gswdh/PSU-Hardware/sim.asc

C1: cap; 22p
C2: cap; 220p
C3: cap; 10µ
C4: cap; 10p
C6: cap; 100n
L1: ind; 1µ
L2: ind; 1µ
M1: nmos; BSG0811NDQ2
M2: nmos; BSG0811NDQ2
R1: res; 10
R2: res; 1
R3: res; 3k
R4: res; 1k
R5: res; 10
R6: res; 3k
R7: res; 1k
R8: res; 1Meg
R9: res; 10
R11: res; 10k
R12: res; 10k
R13: res; 10k
R14: res; 10k
U1: LT1630
U2: LT1630
U3: LT1630
V1: voltage; 15
V2: voltage; 5
V3: voltage; 11
V5: voltage; 1
Named nets: +15V, -5V, 0, VOUT+, VOUT-, +15v, isense, vsense
.tran 1u 1m
