gswdh/PSU-Hardware/power.brd

## EAGLE design power.brd (2020-10-30)

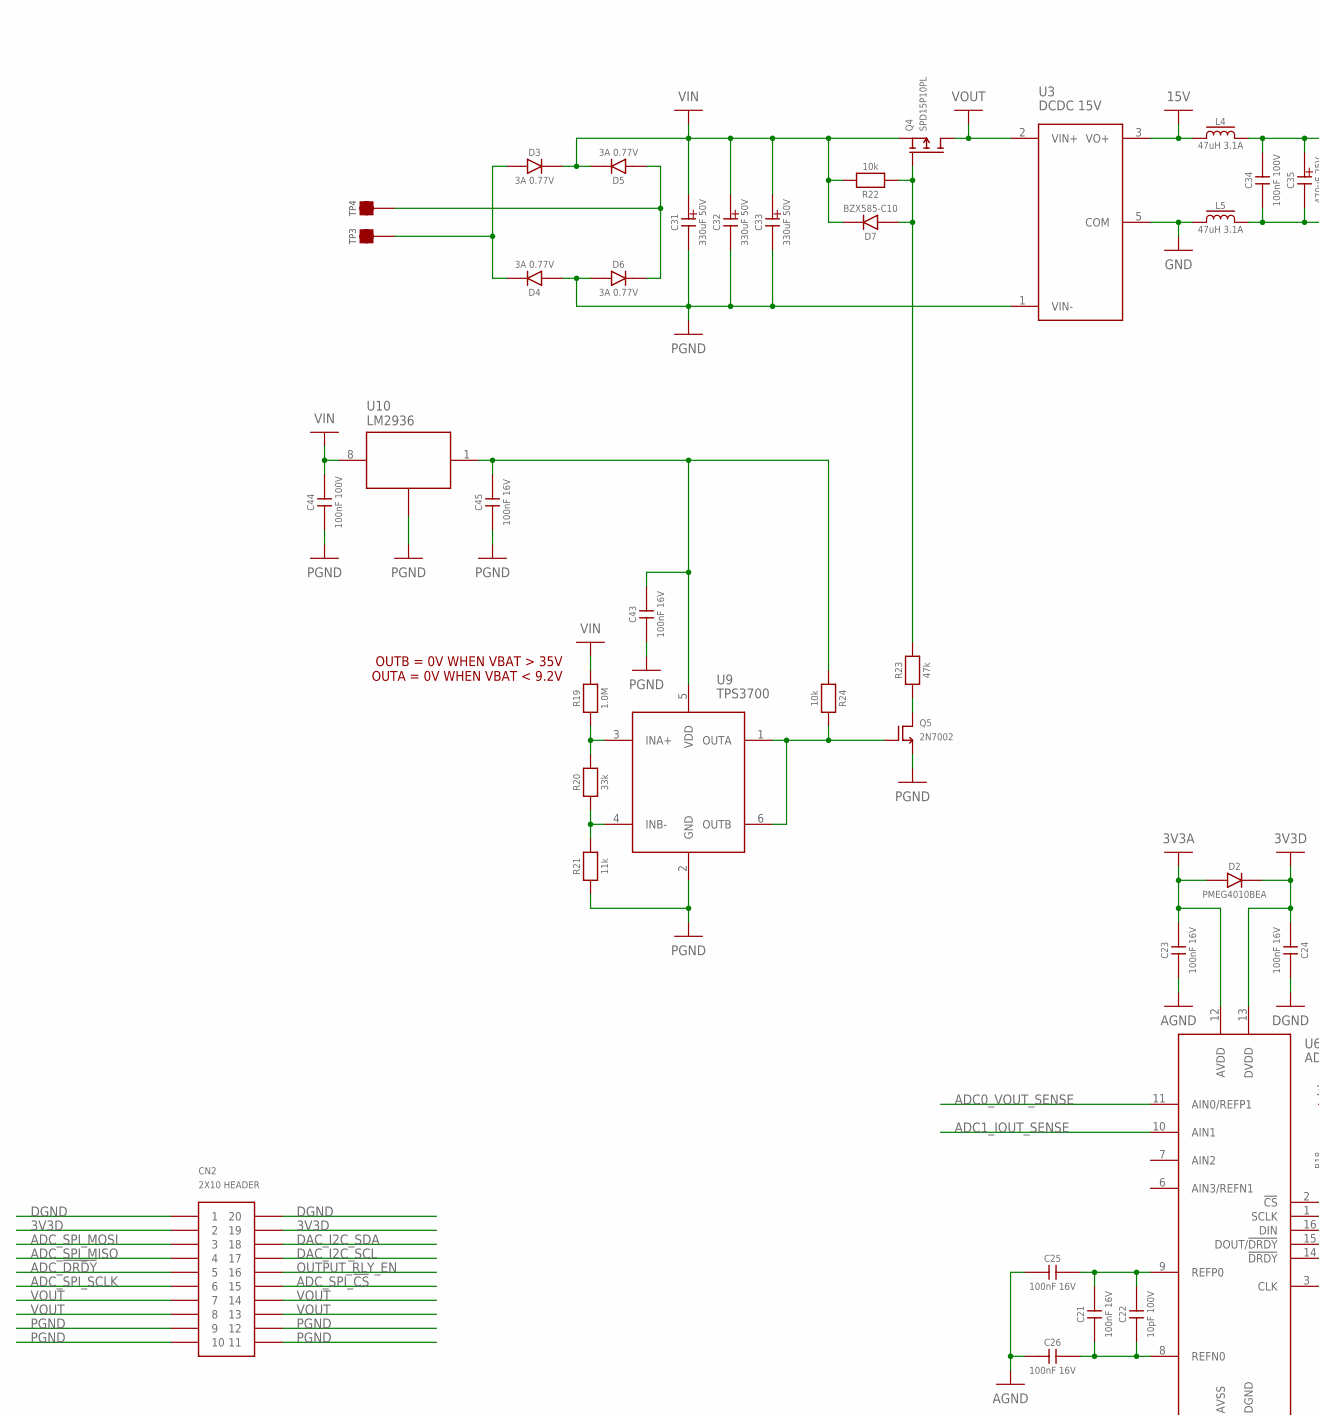
[picture p1: schematic power.sch, part in row 1, column 1]

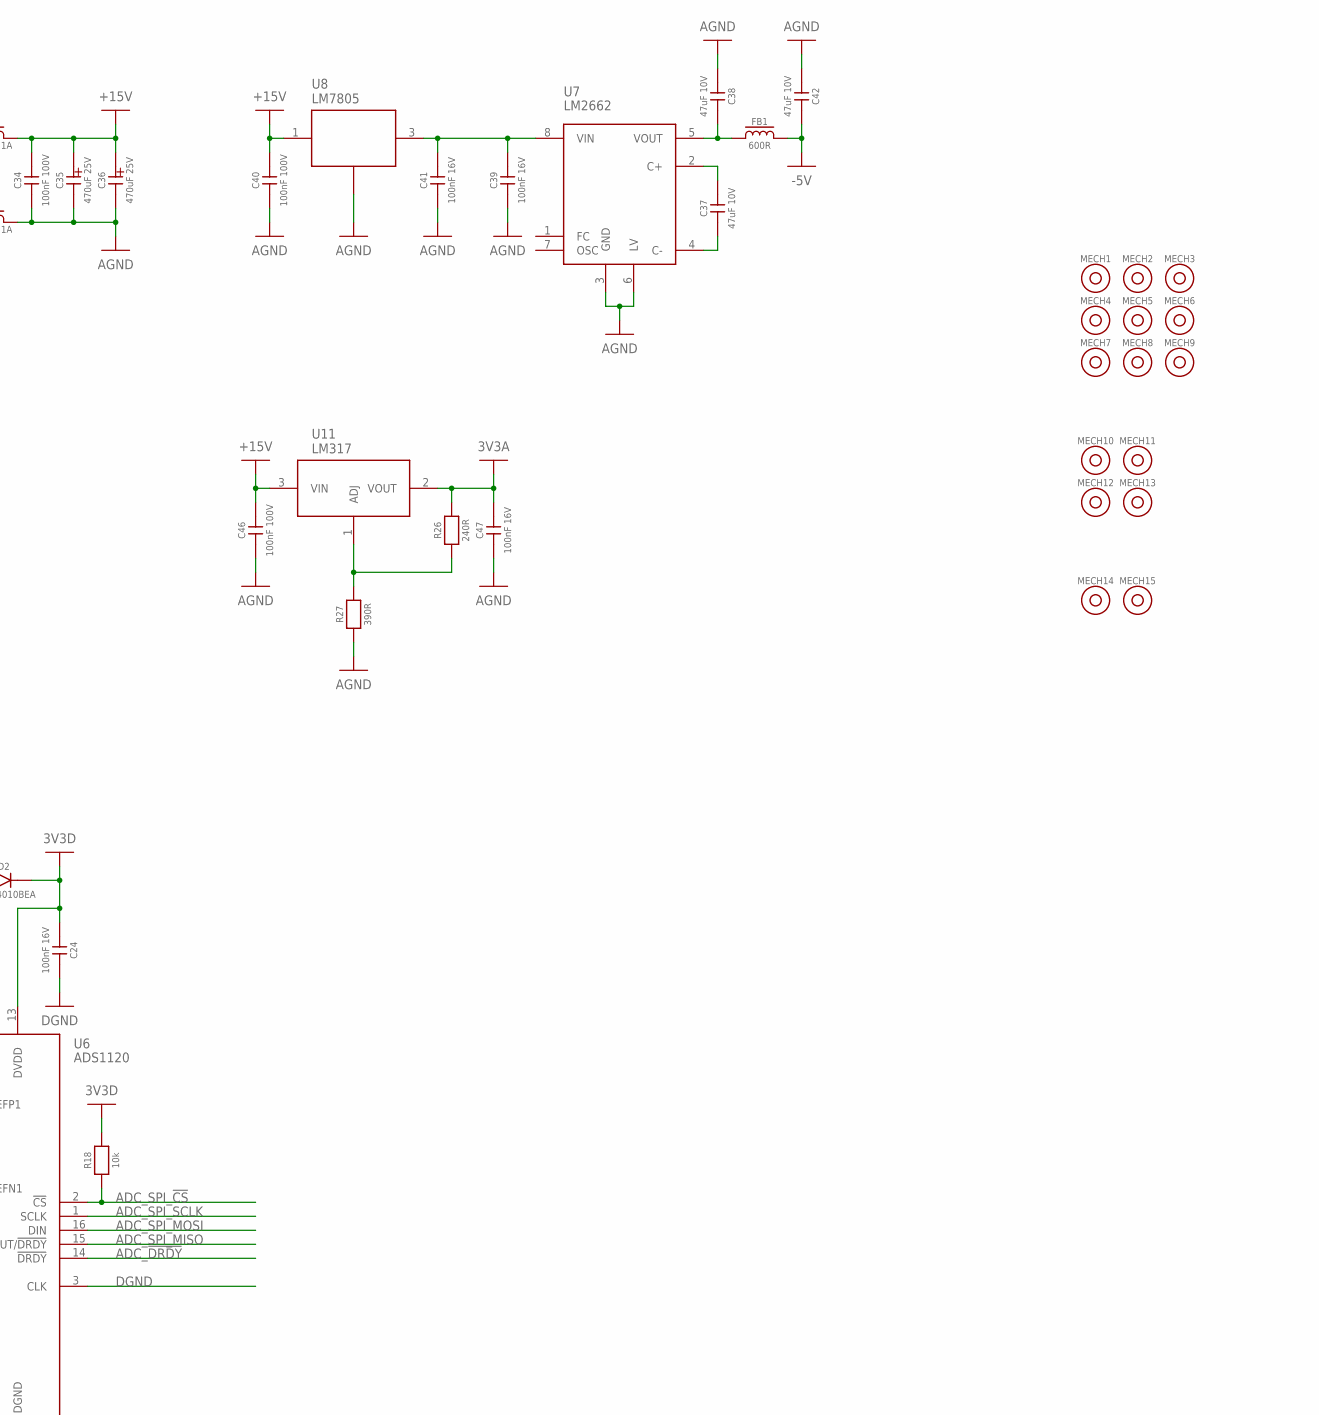
[picture p2: schematic power.sch, part in row 1, column 2]

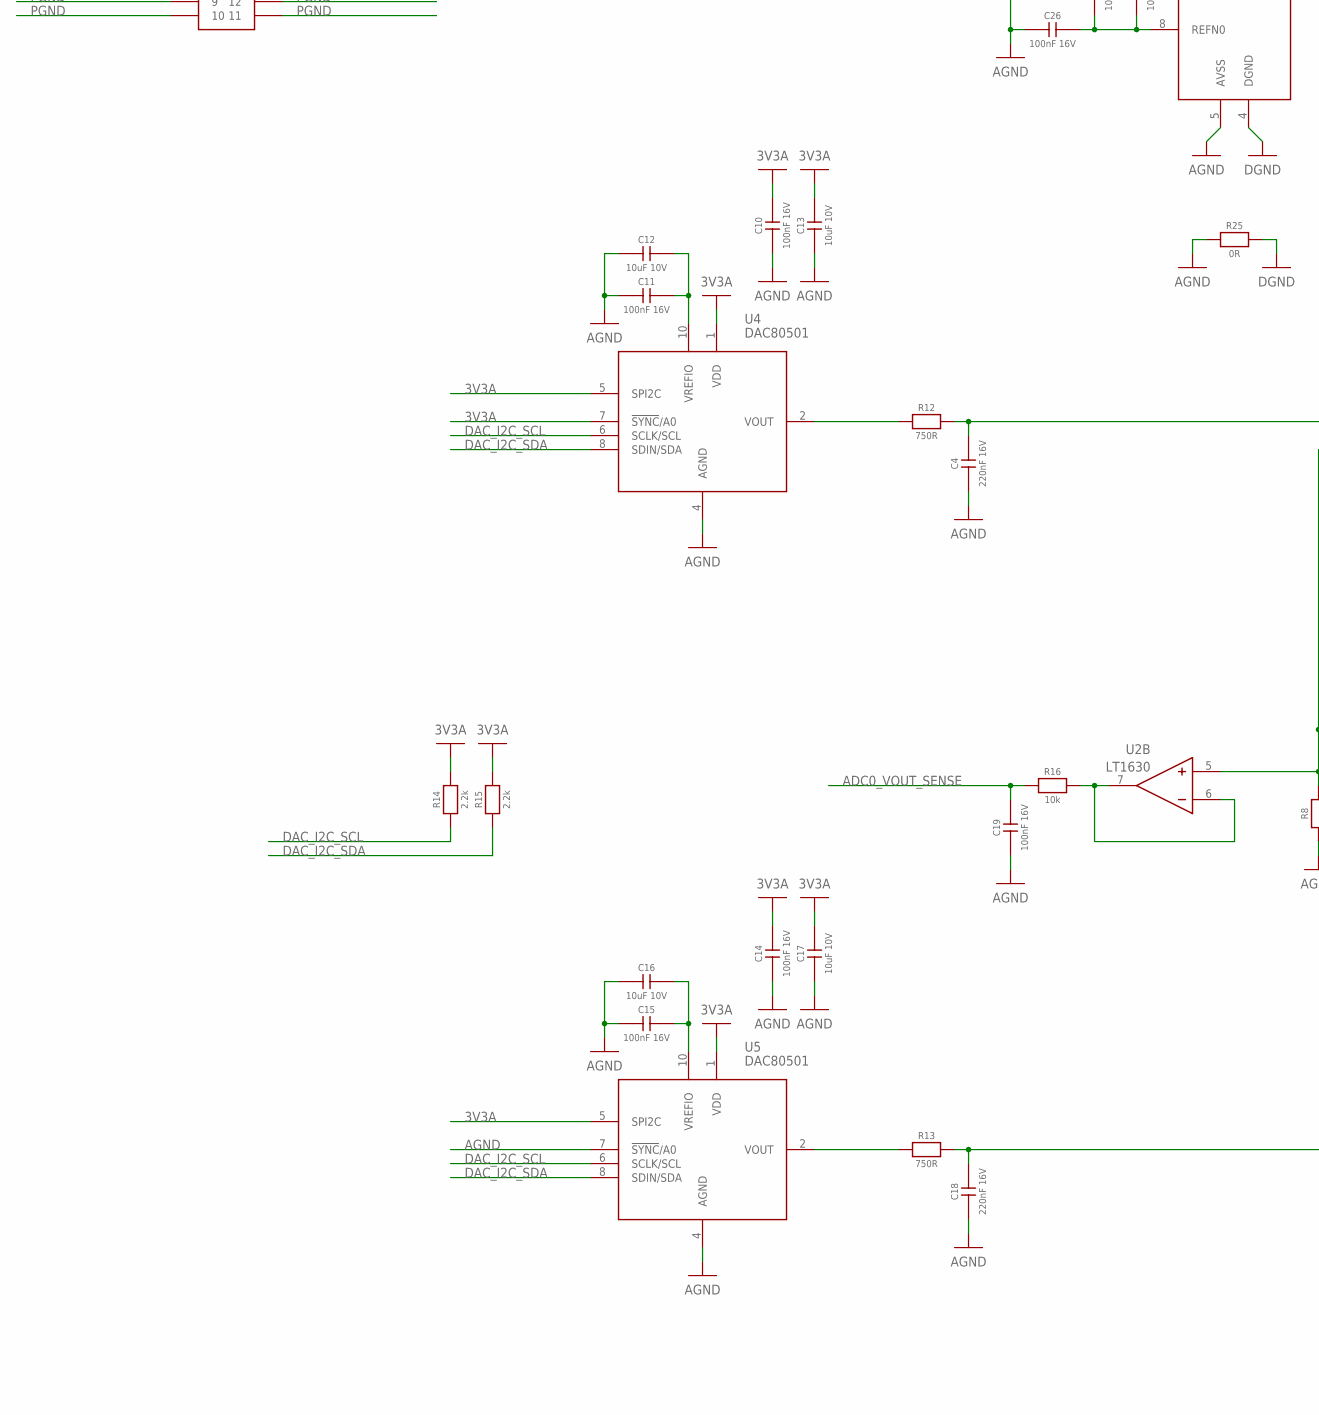
[picture p3: schematic power.sch, part in row 2, column 1]

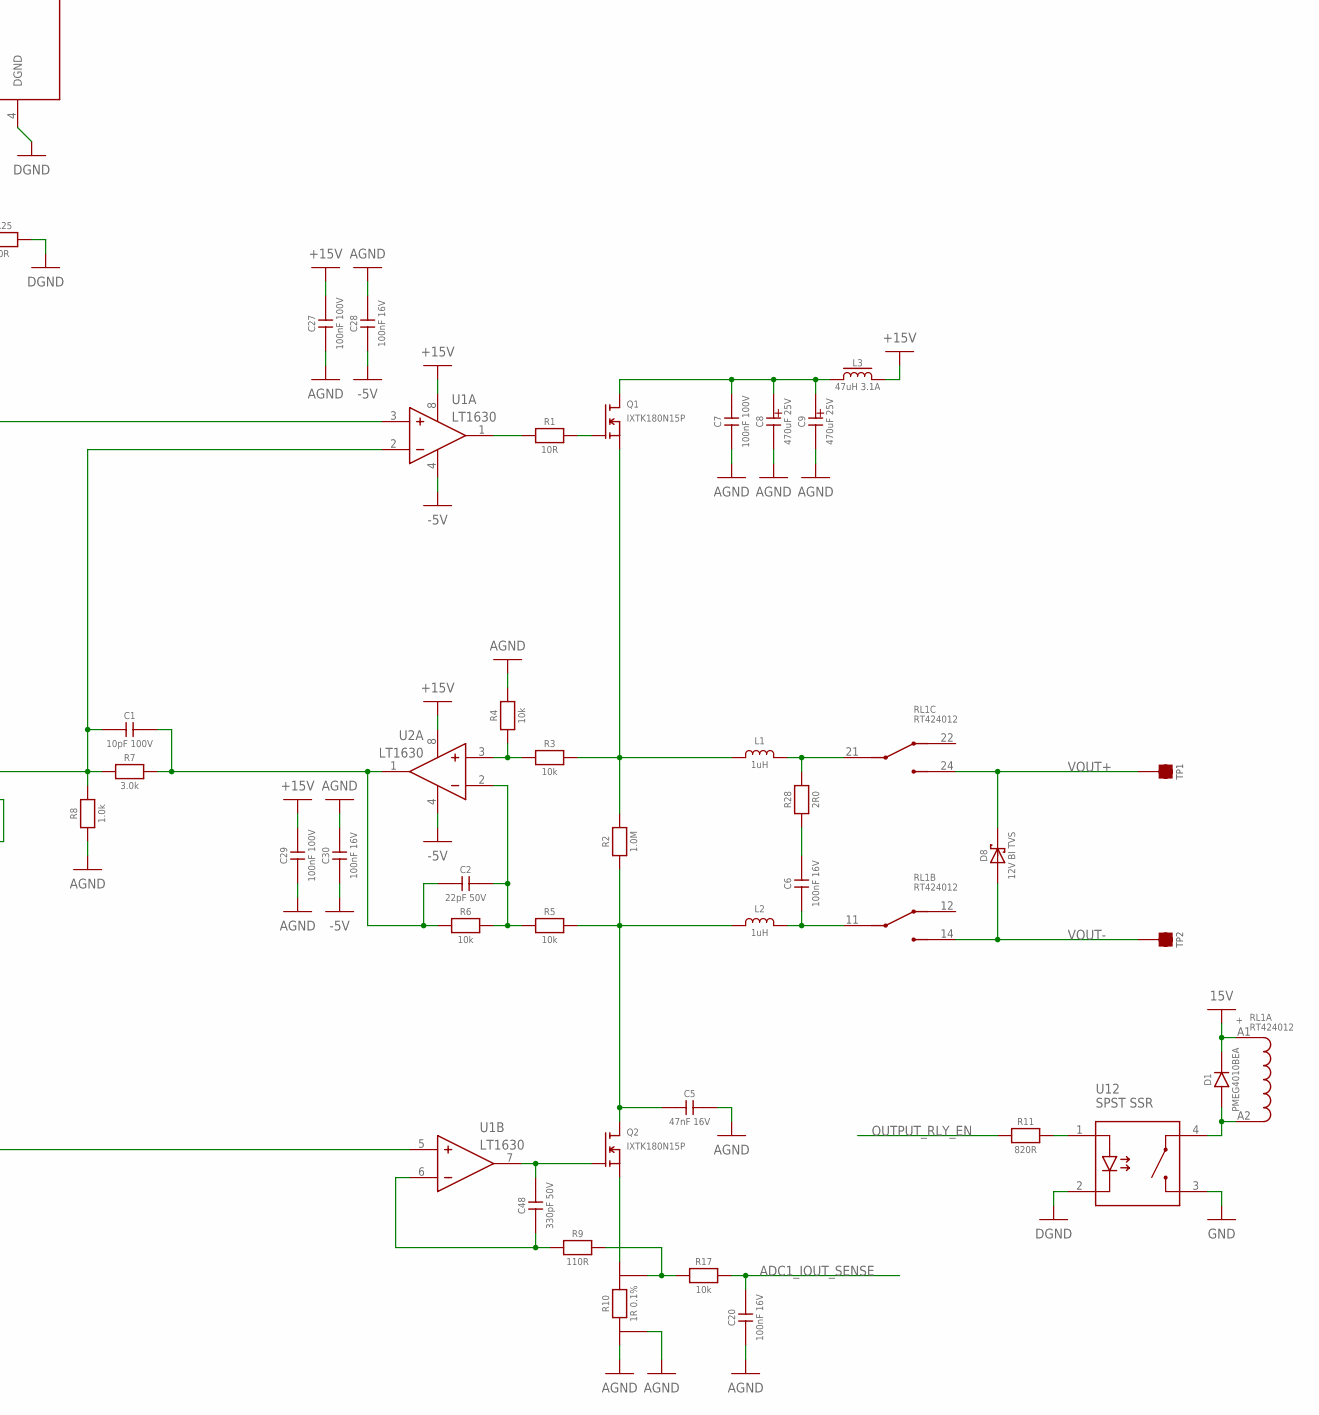
[picture p4: schematic power.sch, part in row 2, column 2]

Parts:
C1, C22: 10pF 100V; 0603
C2: 22pF 50V; 0603
C4, C18: 220nF 16V; 0603
C5: 47nF 16V; 0603
C6, C10, C11, C14, C15, C19, C20, C21, C23, C24, C25, C26, C28, C30, C39, C41, C43, C45, C47: 100nF 16V; 0603
C7, C27, C29, C34, C40, C44, C46: 100nF 100V; 0603
C8, C9, C35, C36: 470uF 25V; 10MM_RADIAL_5MM_PITCH
C12, C13, C16, C17: 10uF 10V; 0603
C31, C32, C33: 330uF 50V; 10MM_RADIAL_5MM_PITCH
C37, C38, C42: 47uF 10V; 1206
C48: 330pF 50V; 0603
CN2: 2X10 HEADER; 2X10PIN_HEADER
D1, D2: PMEG4010BEA; SOD-323
D3, D4, D5, D6: 3A 0.77V; SOD128
D7: BZX585-C10; SOD_523
D8: 12V BI TVS; DO214AC
FB1: 600R; 0603
L1, L2: 1uH; DIY_10X13MM_INDUCTOR
L3, L4, L5: 47uH 3.1A; SRR1210
MECH1, MECH2, MECH3, MECH4, MECH5, MECH6, MECH7, MECH8, MECH9, MECH10, MECH11, MECH12, MECH13, MECH14, MECH15: 6mm x 3mm; MOUNTHOLE_6X3
Q1, Q2: IXTK180N15P; TO264F
Q4: SPD15P10PL; TO252
Q5: 2N7002; SOT23-3
R1: 10R; 0603
R2, R19: 1.0M; 0603
R3, R4, R5, R6, R16, R17, R18, R22, R24: 10k; 0603
R7: 3.0k; 0603
R8: 1.0k; 0603
R9: 110R; 0603
R10: 1R 0.1%; 2512_4WIRE
R11: 820R; 0603
R12, R13: 750R; 0603
R14, R15: 2.2k; 0603
R20: 33k; 0603
R21: 11k; 0603
R23: 47k; 0603
R25: 0R; 0603
R26: 240R; 0603
R27: 390R; 0603
R28: 2R0; 1206
RL1: RT424012; 30MMDPDTRELAY
TP1, TP2, TP3, TP4: TEST_POINT_SQUARE; OSPREY_HSS_PAD
U1, U2: LT1630; SO8
U3: DCDC 15V; PDQE10
U4, U5: DAC80501; VSSOP10
U6: ADS1120; TSSOP16
U7: LM2662; SO8
U8: LM7805; TO220
U9: TPS3700; SOT23-6
U10: LM2936; SO8
U11: LM317; TO220
U12: SPST SSR; CPC1002N

Connections:
3V3A: C10.2, C13.2, C14.2, C17.2, C23.2, C47.2, D2.A, R14.2, R15.2, R26.2, U4.1 (VDD), U4.5 (SPI2C), U4.7 (!SYNC!/A0), U5.1 (VDD), U5.5 (SPI2C), U6.12 (AVDD), U11.2 (VOUT)
3V3D: C24.1, CN2.2, CN2.19, D2.K, R18.2, U6.13 (DVDD)
15V: D1.K, L4.1, RL1.A1, U3.3 (VO+)
+15V: C27.2, C29.2, C34.2, C35.2 (A), C36.2 (A), C40.2, C46.2, L3.2, L4.2, U1.8 (V+), U2.8 (V+), U8.1 (VIN), U11.3 (VIN)
-5V: C28.1, C30.1, C42.2, FB1.2, U1.4 (V-), U2.4 (V-)
ADC0_VOUT_SENSE: C19.2, R16.1, U6.11 (AIN0/REFP1)
ADC1_IOUT_SENSE: C20.2, R17.2, U6.10 (AIN1)
ADC_!DRDY: CN2.5, U6.14 (!DRDY)
ADC_SPI_!CS: CN2.15, R18.1, U6.2 (!CS)
ADC_SPI_MISO: CN2.4, U6.15 (DOUT/!DRDY)
ADC_SPI_MOSI: CN2.3, U6.16 (DIN)
ADC_SPI_SCLK: CN2.6, U6.1 (SCLK)
AGND: C4.1, C5.2, C7.1, C8.1 (K), C9.1 (K), C10.1, C11.1, C12.1, C13.1, C14.1, C15.1, C16.1, C17.1, C18.1, C19.1, C20.1, C23.1, C25.1, C26.1, C27.1, C28.2, C29.1, C30.2, C34.1, C35.1 (K), C36.1 (K), C38.1, C39.1, C40.1, C41.1, C42.1, C46.1, C47.1, L5.2, R4.2, R8.1, R10.1 (E1), R10.2 (I1), R25.1, R27.1, U4.4 (AGND), U5.4 (AGND), U5.7 (!SYNC!/A0), U6.5 (AVSS), U7.3 (GND), U7.6 (LV), U8.2 (GND)
DAC_I2C_SCL: CN2.17, R14.1, U4.6 (SCLK/SCL), U5.6 (SCLK/SCL)
DAC_I2C_SDA: CN2.18, R15.1, U4.8 (SDIN/SDA), U5.8 (SDIN/SDA)
DGND: C24.2, CN2.1, CN2.20, R25.2, U6.3 (CLK), U6.4 (DGND), U12.2 (LED_K)
GND: L5.1, U3.5 (COM), U12.3 (SW2)
unnamed: R1.1, U1.1 (OUT)
unnamed: Q1.1 (G), R1.2
unnamed: L1.1, Q1.3 (S), R2.2, R3.2
unnamed: C5.1, L2.1, Q2.2 (D), R2.1, R5.2
unnamed: R3.1, R4.1, U2.3 (+)
unnamed: C2.2, R5.1, R6.2, U2.2 (-)
unnamed: C1.2, C2.1, R6.1, R7.2, U2.1 (OUT)
unnamed: R16.2, U2.6 (-), U2.7 (OUT)
unnamed: C48.2, Q2.1 (G), U1.7 (OUT)
unnamed: C4.2, R12.2, U1.3 (+)
unnamed: C48.1, R9.1, U1.6 (-)
unnamed: L1.2, R28.2, RL1.21 (1)
unnamed: R11.2, U12.1 (LED_A)
unnamed: C6.1, L2.2, RL1.11 (1)
unnamed: R26.1, R27.2, U11.1 (ADJ)
unnamed: C21.2, C22.2, C25.2, U6.9 (REFP0)
unnamed: C7.2, C8.2 (A), C9.2 (A), L3.1, Q1.2 (D)
unnamed: C18.2, R13.2, U1.5 (+)
unnamed: D1.A, RL1.A2, U12.4 (SW1)
unnamed: C11.2, C12.2, U4.10 (VREFIO)
unnamed: R12.1, U4.2 (VOUT)
unnamed: C15.2, C16.2, U5.10 (VREFIO)
unnamed: R13.1, U5.2 (VOUT)
unnamed: C21.1, C22.1, C26.2, U6.8 (REFN0)
unnamed: C43.2, C45.2, R24.1, U9.5 (VDD), U10.1 (VOUT)
unnamed: D5.A, D6.K, TP4.1
unnamed: D3.A, D4.K, TP3.1
unnamed: C6.2, R28.1
unnamed: Q2.3 (S), R10.4 (I2)
unnamed: C37.2, U7.2 (C+)
unnamed: C37.1, U7.4 (C-)
unnamed: C38.2, FB1.1, U7.5 (VOUT)
unnamed: C39.2, C41.2, U7.8 (VIN), U8.3 (VOUT)
unnamed: R19.1, R20.2, U9.3 (INA+)
unnamed: R20.1, R21.2, U9.4 (INB-)
unnamed: D7.A, Q4.1 (G), R22.1, R23.2
unnamed: Q5.2 (D), R23.1
unnamed: Q5.1 (G), R24.2, U9.1 (OUTA), U9.6 (OUTB)
unnamed: R9.2, R10.3 (E2), R17.1
unnamed: C1.1, R7.1, R8.2, U1.2 (-), U2.5 (+)
OUTPUT_RLY_EN: CN2.16, R11.1
PGND: C31.1 (K), C32.1 (K), C33.1 (K), C43.1, C44.1, C45.1, CN2.9, CN2.10, CN2.11, CN2.12, D4.A, D6.A, Q5.3 (S), R21.1, U3.1 (VIN-), U9.2 (GND), U10.2 (GND), U10.3 (GND), U10.6 (GND), U10.7 (GND)
VIN: C31.2 (A), C32.2 (A), C33.2 (A), C44.2, D3.K, D5.K, D7.K, Q4.3 (S), R19.2, R22.2, U10.8 (VIN)
VOUT: CN2.7, CN2.8, CN2.13, CN2.14, Q4.2 (D), U3.2 (VIN+)
VOUT+: D8.K, RL1.24 (3), TP1.1
VOUT-: D8.A, RL1.14 (3), TP2.1

Notes on the sheet:
OUTB = 0V WHEN VBAT > 35V OUTA = 0V WHEN VBAT < 9.2V

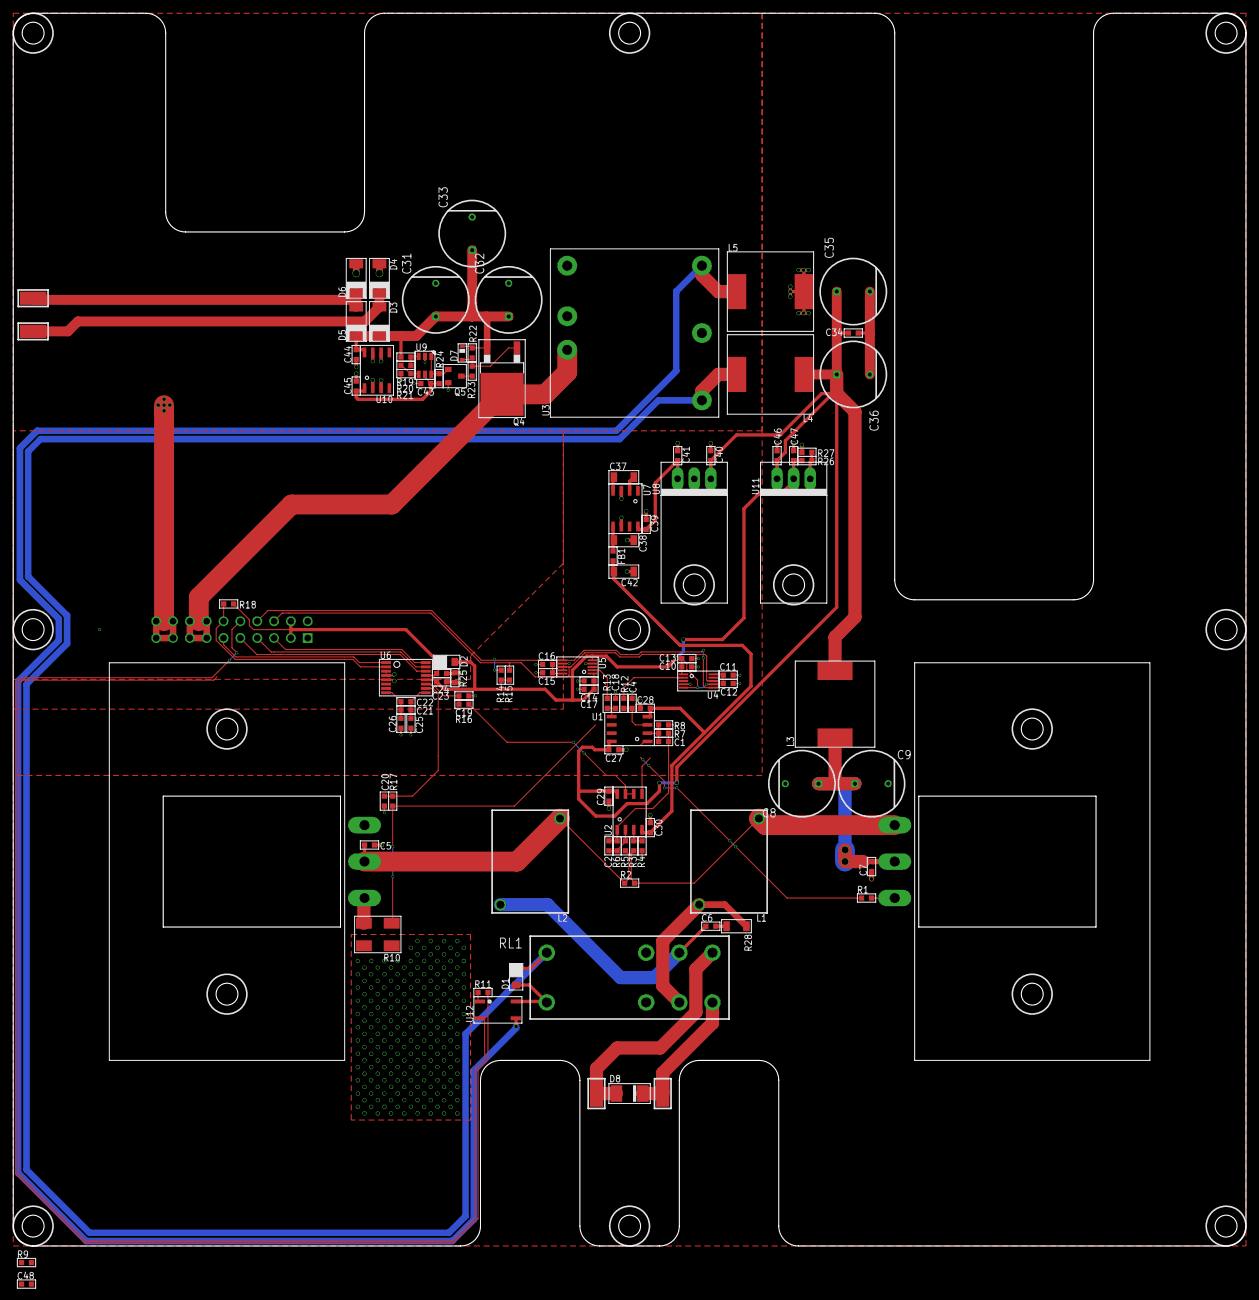
[picture p5: board power.brd from above]

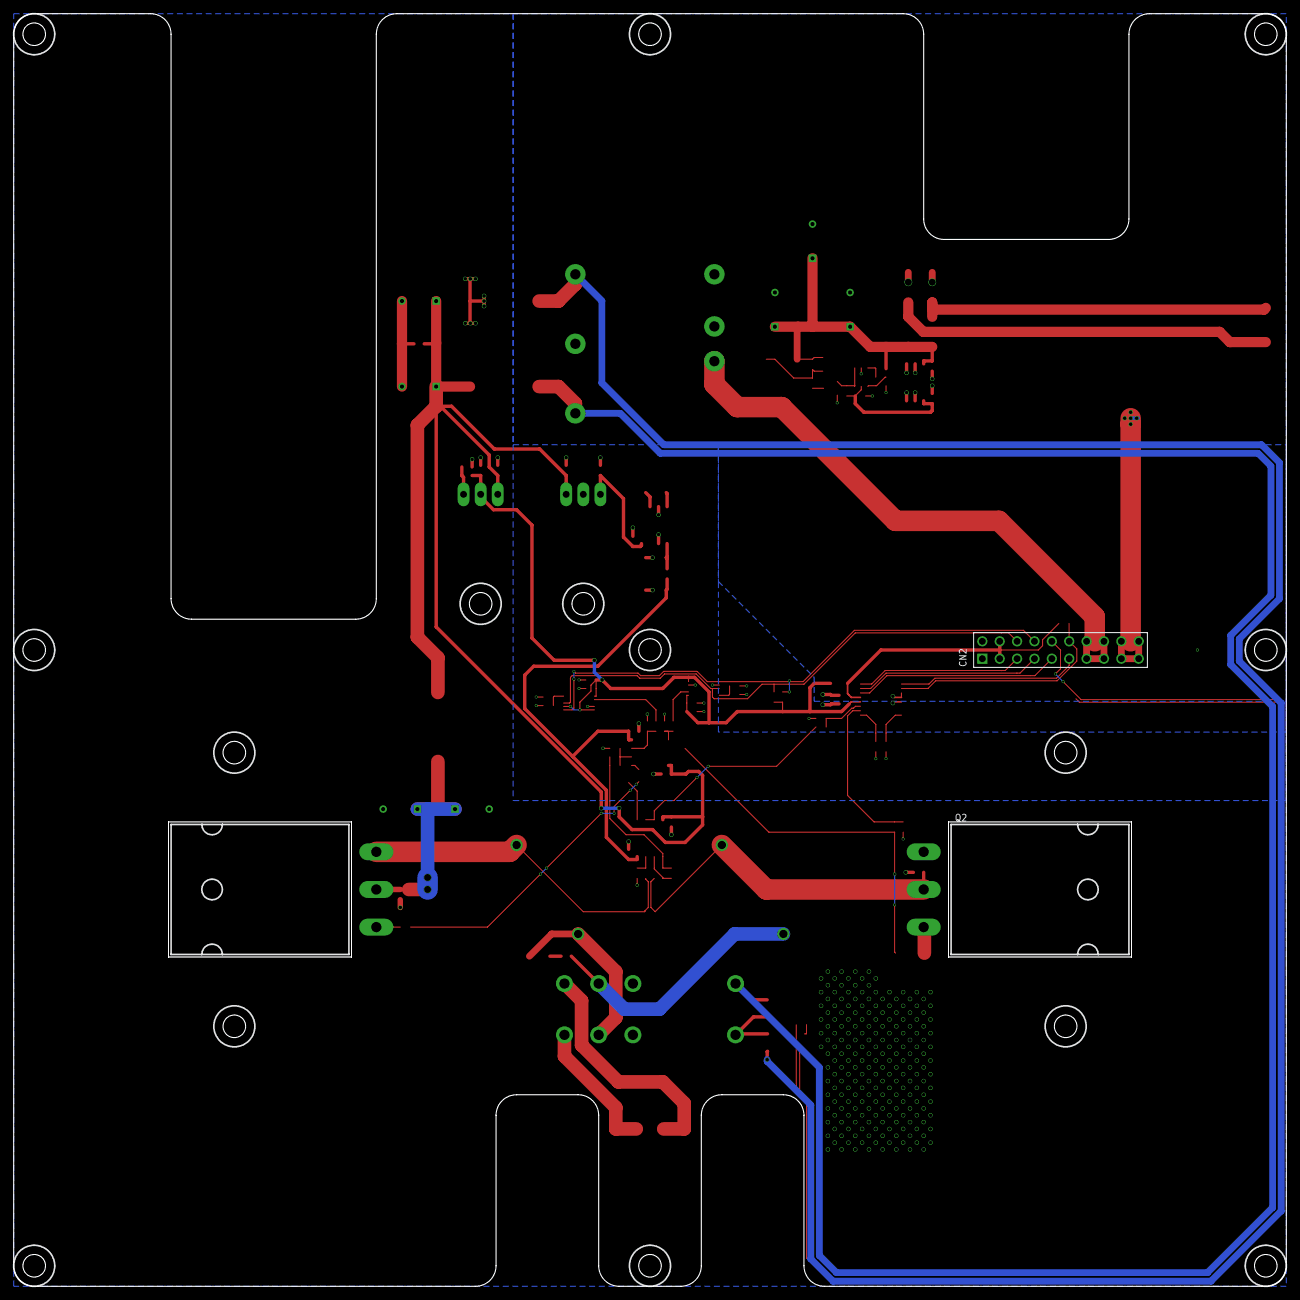
[picture p6: board power.brd from below]

Board: 4 copper layers, 186.0 x 186.0 mm, 126 parts (3 on the bottom side), 63 nets.
