gswdh/PSU-Hardware/control.brd

## EAGLE design control.brd (2020-10-30)

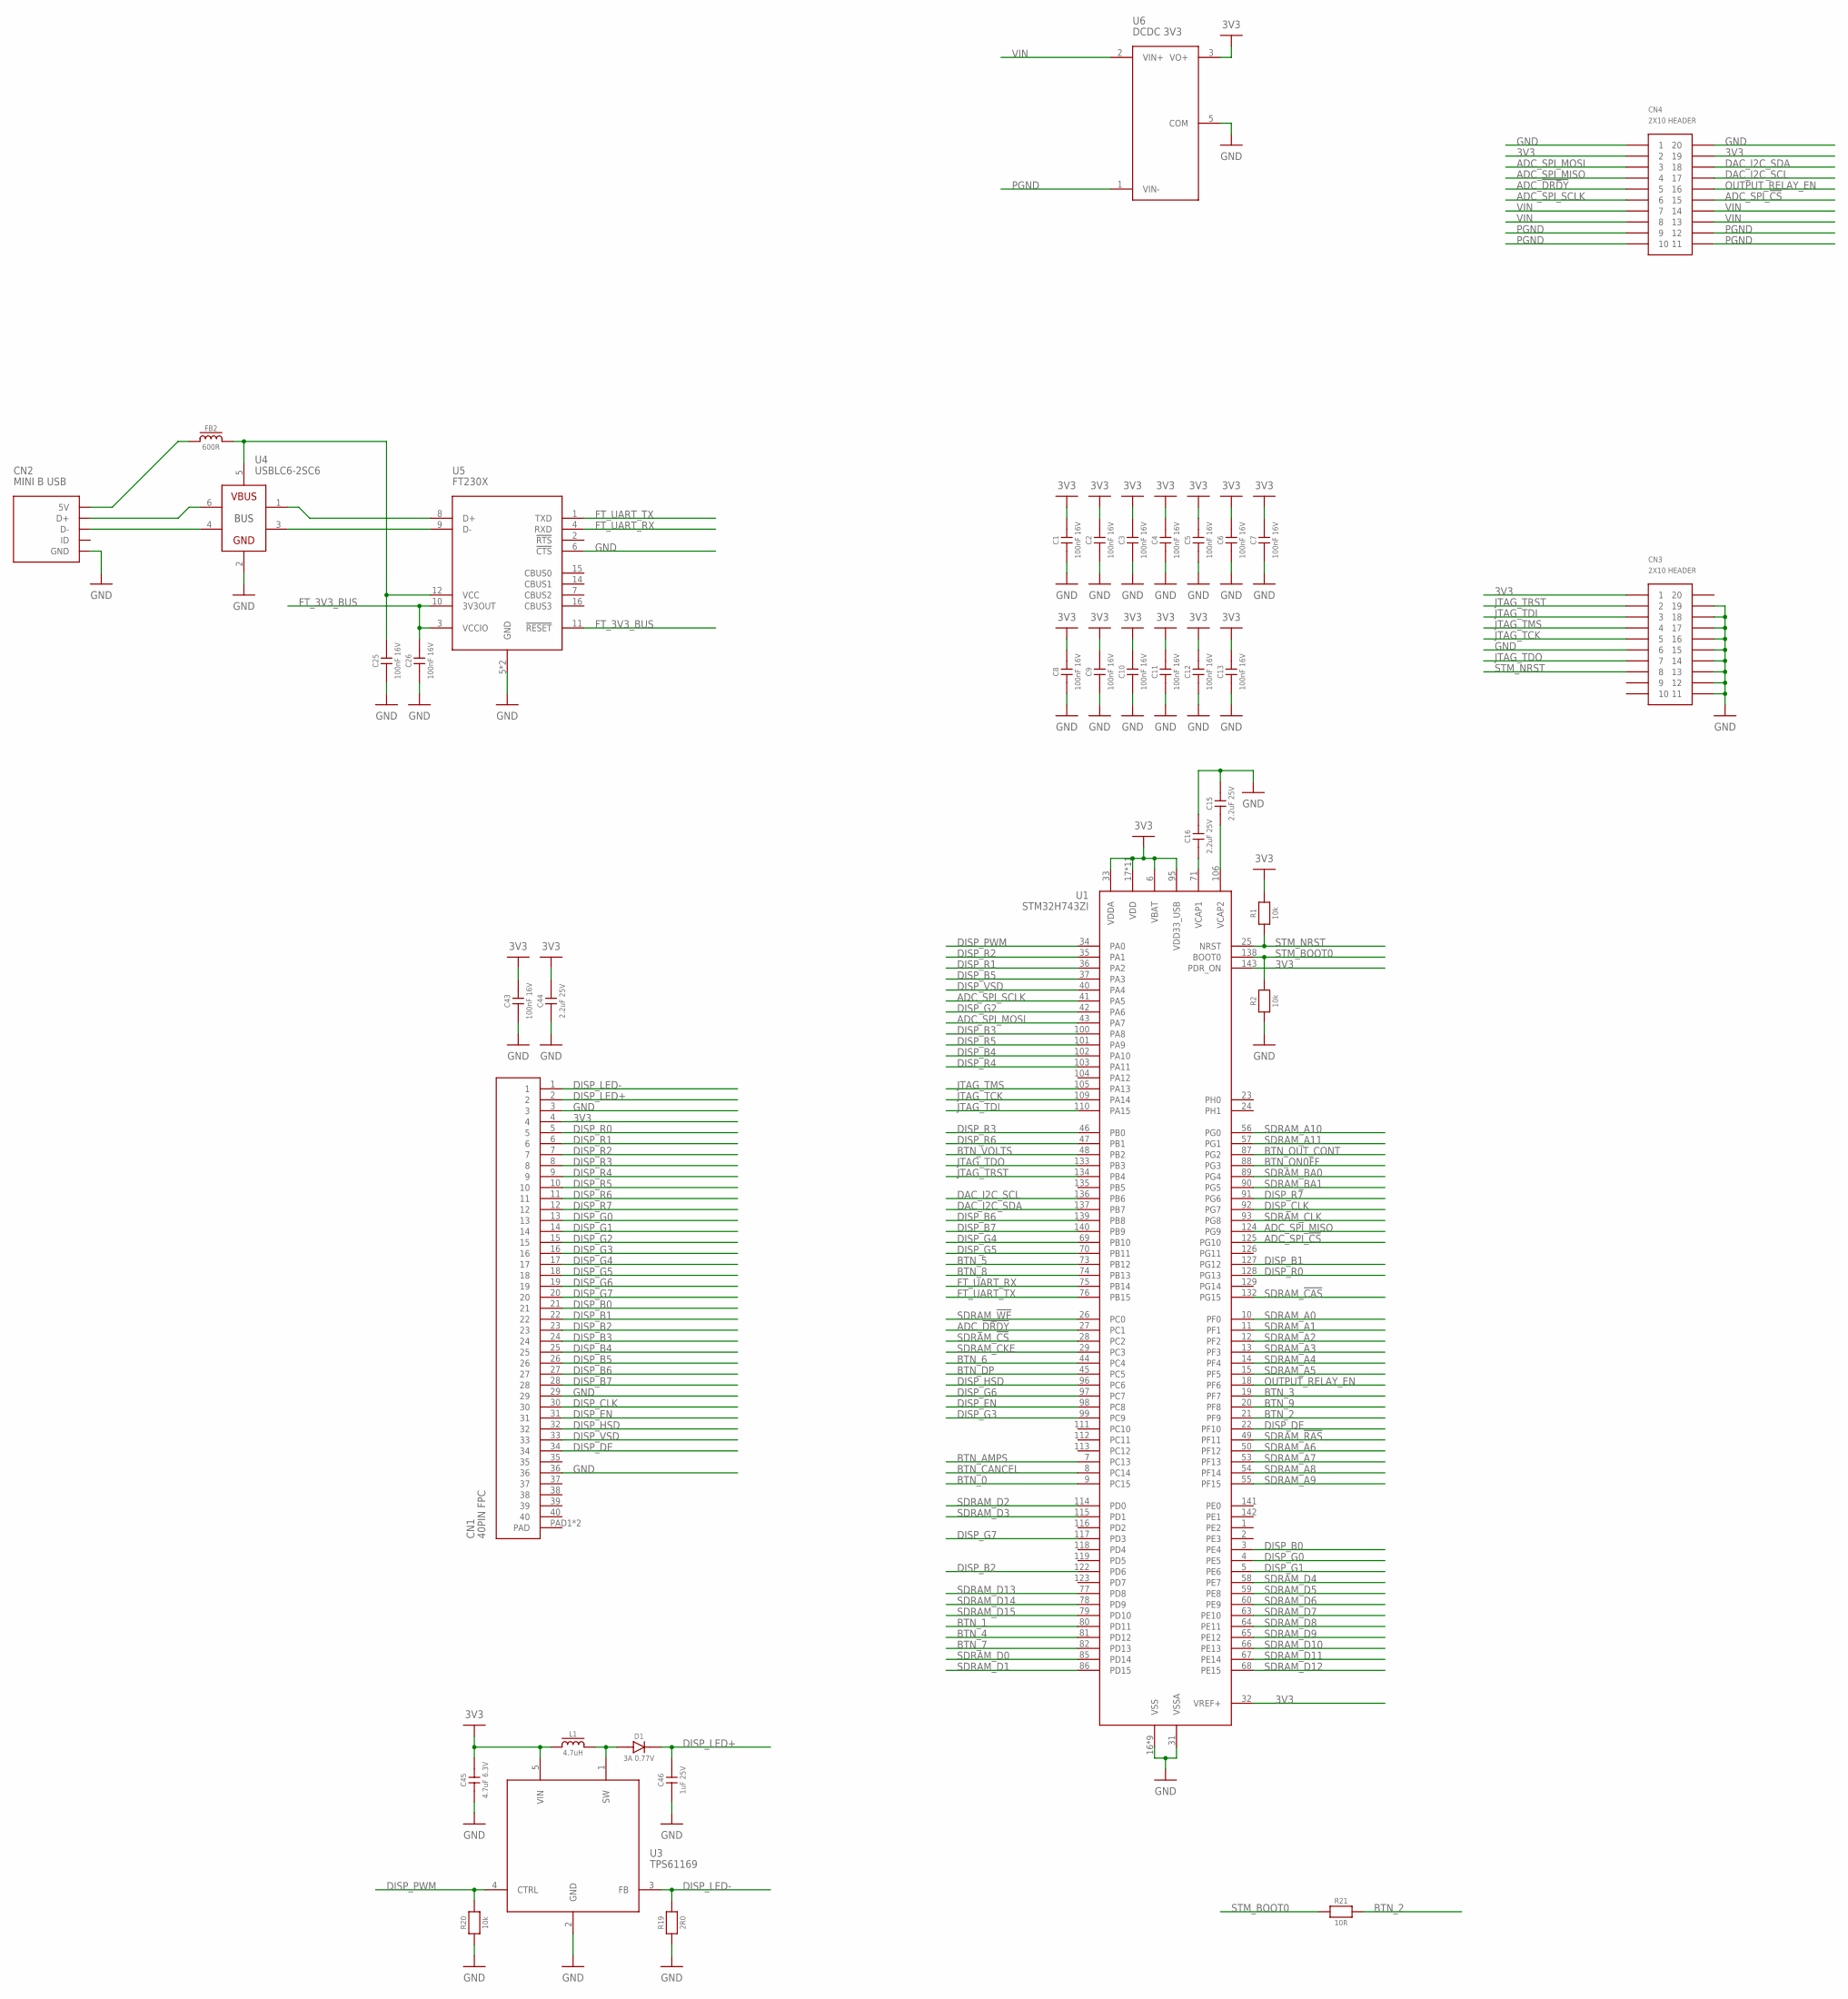
[picture p7: schematic control.sch, sheet 1, MCU]

Parts:
C1, C2, C3, C4, C5, C6, C7, C8, C9, C10, C11, C12, C13, C25, C26, C43: 100nF 16V; 0603
C15, C16, C44: 2.2uF 25V; 0603
C45: 4.7uF 6.3V; 0603
C46: 1uF 25V; 0603
CN1: 40PIN FPC; XF2M40151A
CN2: MINI B USB; MUSB-05-S-B-SM-A
CN3, CN4: 2X10 HEADER; 2X10PIN_HEADER
D1: 3A 0.77V; SOD128
FB2: 600R; 0603
L1: 4.7uH; SRN6045
R1, R2, R20: 10k; 0603
R19: 2R0; 1206
R21: 10R; 0603
U1: STM32H743ZI; QFP144
U3: TPS61169; SOT23-5
U4: USBLC6-2SC6; SOT23-6
U5: FT230X; SSOP16-4MM
U6: DCDC 3V3; PDQE10

Connections:
3V3: C1.2, C2.2, C3.2, C4.2, C5.2, C6.2, C7.2, C8.2, C9.2, C10.2, C11.2, C12.2, C13.2, C43.2, C44.2, C45.2, CN1.4, CN3.1, CN4.2, CN4.19, L1.1, R1.2, U1.6 (VBAT), U1.17 (VDD), U1.30 (VDD), U1.32 (VREF+), U1.33 (VDDA), U1.39 (VDD), U1.52 (VDD), U1.62 (VDD), U1.72 (VDD), U1.84 (VDD), U1.95 (VDD33_USB), U1.108 (VDD), U1.121 (VDD), U1.131 (VDD), U1.143 (PDR_ON), U1.144 (VDD), U3.5 (VIN), U6.3 (VO+); also elsewhere on the board
ADC_!DRDY: CN4.5, U1.27 (PC1)
ADC_SPI_!CS: CN4.15, U1.125 (PG10)
ADC_SPI_MISO: CN4.4, U1.124 (PG9)
ADC_SPI_MOSI: CN4.3, U1.43 (PA7)
ADC_SPI_SCLK: CN4.6, U1.41 (PA5)
BTN_0: U1.9 (PC15); also elsewhere on the board
BTN_1: U1.80 (PD11); also elsewhere on the board
BTN_2: R21.2, U1.21 (PF9); also elsewhere on the board
BTN_3: U1.19 (PF7); also elsewhere on the board
BTN_4: U1.81 (PD12); also elsewhere on the board
BTN_5: U1.73 (PB12); also elsewhere on the board
BTN_6: U1.44 (PC4); also elsewhere on the board
BTN_7: U1.82 (PD13); also elsewhere on the board
BTN_8: U1.74 (PB13); also elsewhere on the board
BTN_9: U1.20 (PF8); also elsewhere on the board
BTN_AMPS: U1.7 (PC13); also elsewhere on the board
BTN_CANCEL: U1.8 (PC14); also elsewhere on the board
BTN_DP: U1.45 (PC5); also elsewhere on the board
BTN_ON0FF: U1.88 (PG3); also elsewhere on the board
BTN_OUT_CONT: U1.87 (PG2); also elsewhere on the board
BTN_VOLTS: U1.48 (PB2); also elsewhere on the board
DAC_I2C_SCL: CN4.17, U1.136 (PB6)
DAC_I2C_SDA: CN4.18, U1.137 (PB7)
DISP_B0: CN1.21, U1.3 (PE4)
DISP_B1: CN1.22, U1.127 (PG12)
DISP_B2: CN1.23, U1.122 (PD6)
DISP_B3: CN1.24, U1.100 (PA8)
DISP_B4: CN1.25, U1.102 (PA10)
DISP_B5: CN1.26, U1.37 (PA3)
DISP_B6: CN1.27, U1.139 (PB8)
DISP_B7: CN1.28, U1.140 (PB9)
DISP_CLK: CN1.30, U1.92 (PG7)
DISP_DE: CN1.34, U1.22 (PF10)
DISP_EN: CN1.31, U1.98 (PC8)
DISP_G0: CN1.13, U1.4 (PE5)
DISP_G1: CN1.14, U1.5 (PE6)
DISP_G2: CN1.15, U1.42 (PA6)
DISP_G3: CN1.16, U1.99 (PC9)
DISP_G4: CN1.17, U1.69 (PB10)
DISP_G5: CN1.18, U1.70 (PB11)
DISP_G6: CN1.19, U1.97 (PC7)
DISP_G7: CN1.20, U1.117 (PD3)
DISP_HSD: CN1.32, U1.96 (PC6)
DISP_LED+: C46.2, CN1.2, D1.K
DISP_LED-: CN1.1, R19.2, U3.3 (FB)
DISP_PWM: R20.2, U1.34 (PA0), U3.4 (CTRL)
DISP_R0: CN1.5, U1.128 (PG13)
DISP_R1: CN1.6, U1.36 (PA2)
DISP_R2: CN1.7, U1.35 (PA1)
DISP_R3: CN1.8, U1.46 (PB0)
DISP_R4: CN1.9, U1.103 (PA11)
DISP_R5: CN1.10, U1.101 (PA9)
DISP_R6: CN1.11, U1.47 (PB1)
DISP_R7: CN1.12, U1.91 (PG6)
DISP_VSD: CN1.33, U1.40 (PA4)
FT_3V3_BUS: C26.2, U5.3 (VCCIO), U5.10 (3V3OUT), U5.11 (!RESET)
FT_UART_RX: U1.75 (PB14), U5.4 (RXD)
FT_UART_TX: U1.76 (PB15), U5.1 (TXD)
GND: C1.1, C2.1, C3.1, C4.1, C5.1, C6.1, C7.1, C8.1, C9.1, C10.1, C11.1, C12.1, C13.1, C15.2, C16.2, C25.1, C26.1, C43.1, C44.1, C45.1, C46.1, CN1.3, CN1.29, CN1.36, CN2.GND, CN2.SHIELD1 (GND), CN2.SHIELD2 (GND), CN2.SHIELD3 (GND), CN2.SHIELD4 (GND), CN3.6, CN3.11, CN3.12, CN3.13, CN3.14, CN3.15, CN3.16, CN3.17, CN3.18, CN3.19, CN4.1, CN4.20, R2.1, R19.1, R20.1, U1.16 (VSS), U1.31 (VSSA), U1.38 (VSS), U1.51 (VSS), U1.61 (VSS), U1.83 (VSS), U1.94 (VSS), U1.107 (VSS), U1.120 (VSS), U1.130 (VSS), U3.2 (GND), U4.2 (GND), U5.5 (GND), U5.6 (!CTS), U5.13 (GND), U6.5 (COM); also elsewhere on the board
JTAG_TCK: CN3.5, U1.109 (PA14)
JTAG_TDI: CN3.3, U1.110 (PA15)
JTAG_TDO: CN3.7, U1.133 (PB3)
JTAG_TMS: CN3.4, U1.105 (PA13)
JTAG_TRST: CN3.2, U1.134 (PB4)
unnamed: C16.1, U1.71 (VCAP1)
unnamed: C15.1, U1.106 (VCAP2)
unnamed: CN2.D-, U4.4 (D-OUT)
unnamed: CN2.D+, U4.6 (D+_OUT)
unnamed: U4.3 (D-_IN), U5.9 (D-)
unnamed: U4.1 (D+_IN), U5.8 (D+)
unnamed: CN2.VCC (5V), FB2.1
unnamed: C25.2, FB2.2, U4.5 (VBUS), U5.12 (VCC)
unnamed: D1.A, L1.2, U3.1 (SW)
OUTPUT_RELAY_EN: CN4.16, U1.18 (PF6)
PGND: CN4.9, CN4.10, CN4.11, CN4.12, U6.1 (VIN-)
SDRAM_!CAS: U1.132 (PG15)
SDRAM_!CS: U1.28 (PC2)
SDRAM_!RAS: U1.49 (PF11)
SDRAM_!WE: U1.26 (PC0)
SDRAM_A0: U1.10 (PF0)
SDRAM_A1: U1.11 (PF1)
SDRAM_A2: U1.12 (PF2)
SDRAM_A3: U1.13 (PF3)
SDRAM_A4: U1.14 (PF4)
SDRAM_A5: U1.15 (PF5)
SDRAM_A6: U1.50 (PF12)
SDRAM_A7: U1.53 (PF13)
SDRAM_A8: U1.54 (PF14)
SDRAM_A9: U1.55 (PF15)
SDRAM_A10: U1.56 (PG0)
SDRAM_A11: U1.57 (PG1)
SDRAM_BA0: U1.89 (PG4)
SDRAM_BA1: U1.90 (PG5)
SDRAM_CKE: U1.29 (PC3)
SDRAM_CLK: U1.93 (PG8)
SDRAM_D0: U1.85 (PD14)
SDRAM_D1: U1.86 (PD15)
SDRAM_D2: U1.114 (PD0)
SDRAM_D3: U1.115 (PD1)
SDRAM_D4: U1.58 (PE7)
SDRAM_D5: U1.59 (PE8)
SDRAM_D6: U1.60 (PE9)
SDRAM_D7: U1.63 (PE10)
SDRAM_D8: U1.64 (PE11)
SDRAM_D9: U1.65 (PE12)
SDRAM_D10: U1.66 (PE13)
SDRAM_D11: U1.67 (PE14)
SDRAM_D12: U1.68 (PE15)
SDRAM_D13: U1.77 (PD8)
SDRAM_D14: U1.78 (PD9)
SDRAM_D15: U1.79 (PD10)
STM_BOOT0: R2.2, R21.1, U1.138 (BOOT0)
STM_NRST: CN3.8, R1.1, U1.25 (NRST)
VIN: CN4.7, CN4.8, CN4.13, CN4.14, U6.2 (VIN+)

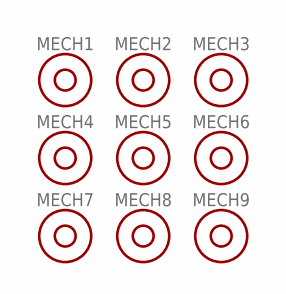
[picture p8: schematic control.sch, sheet 2, MECH]

Parts:
MECH1, MECH2, MECH3, MECH4, MECH5, MECH6, MECH7, MECH8, MECH9: 6mm x 3mm; MOUNTHOLE_6X3
