gswdh/PSU-Hardware/control.brd

## EAGLE design control.brd (continued)

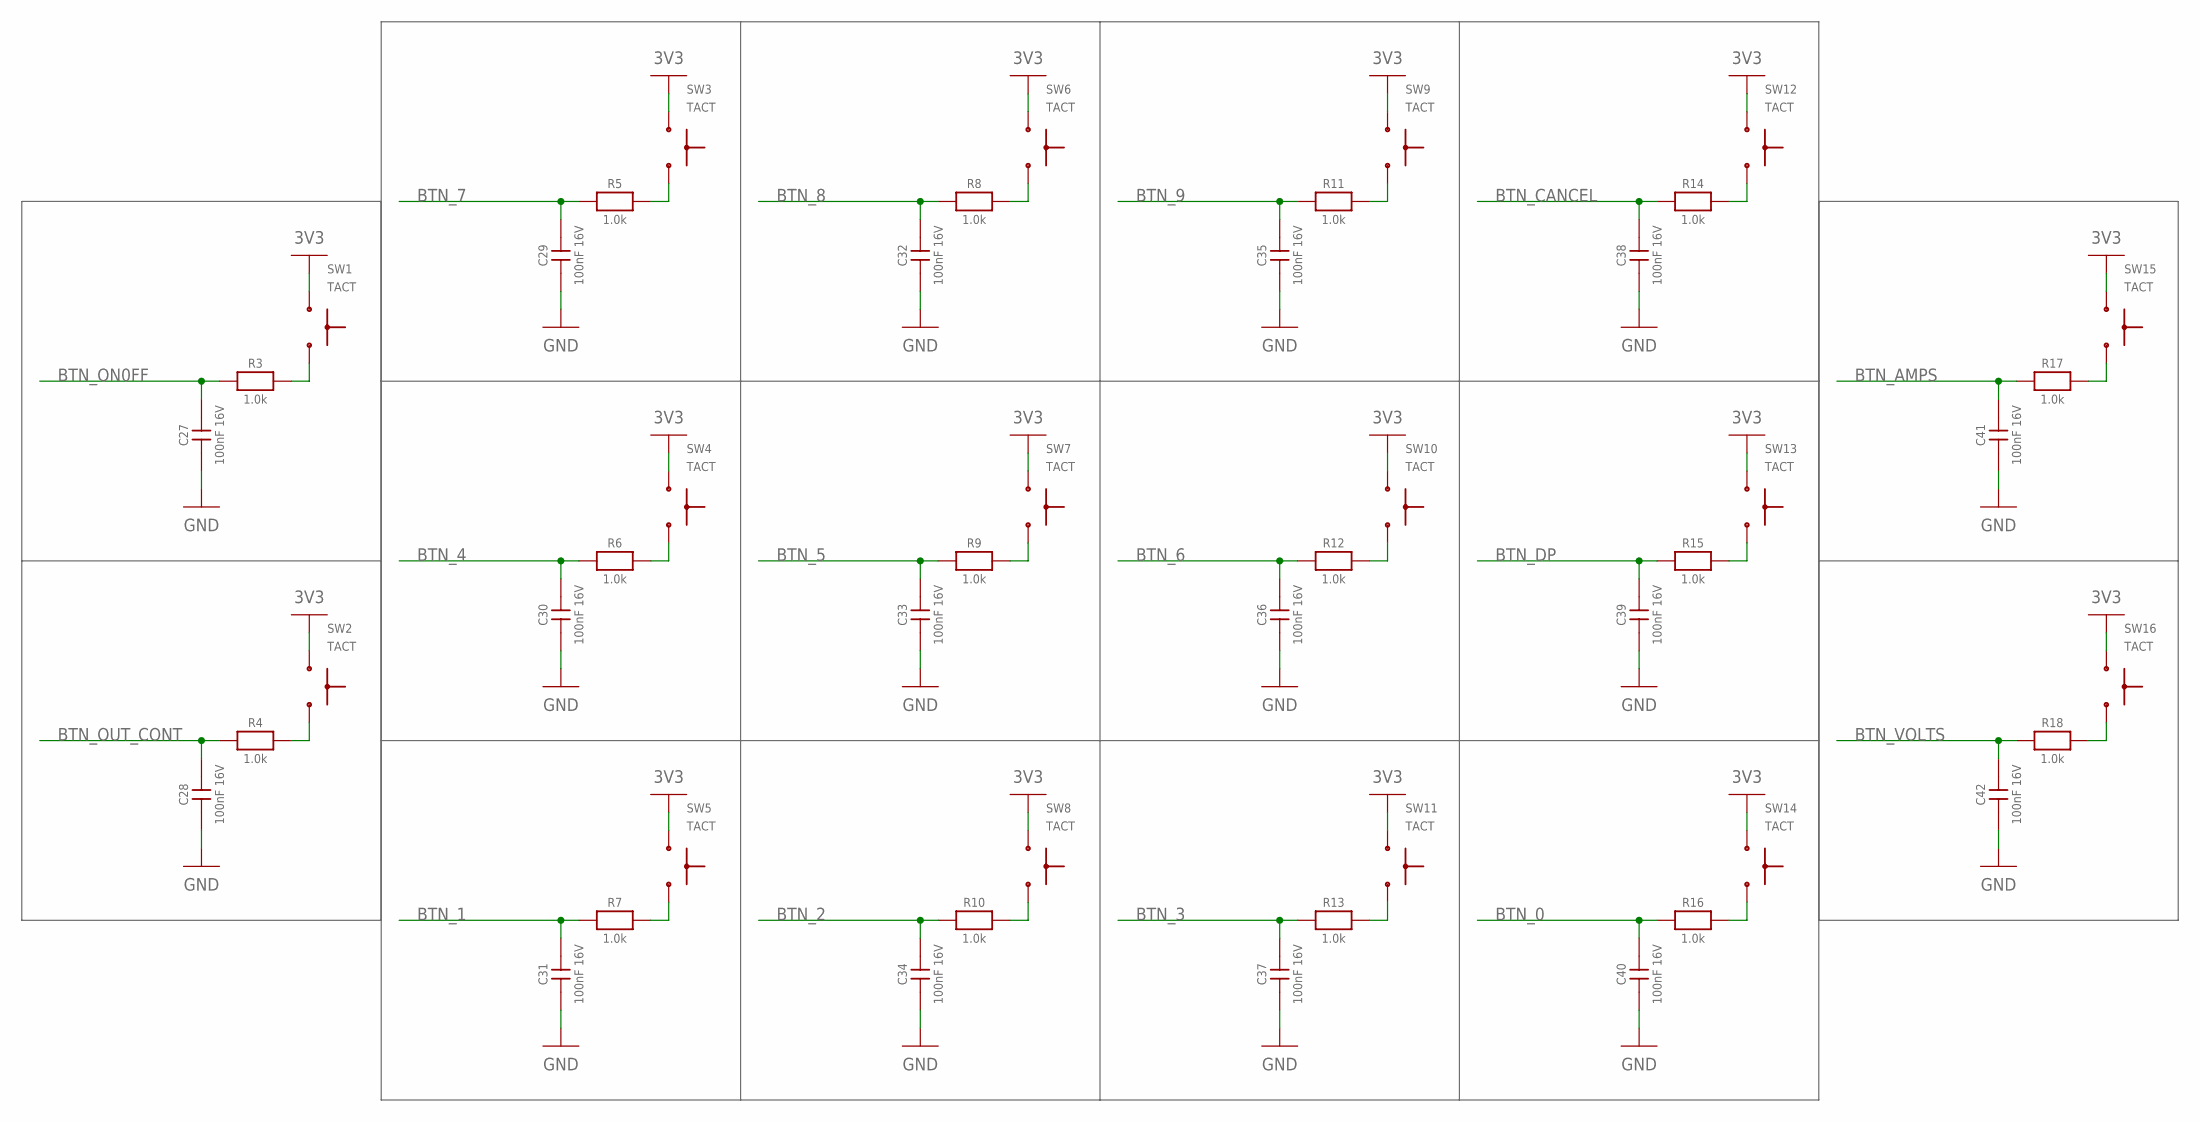
[picture p9: schematic control.sch, sheet 3, BUTTONS]

Parts:
C27, C28, C29, C30, C31, C32, C33, C34, C35, C36, C37, C38, C39, C40, C41, C42: 100nF 16V; 0603
R3, R4, R5, R6, R7, R8, R9, R10, R11, R12, R13, R14, R15, R16, R17, R18: 1.0k; 0603
SW1, SW2, SW3, SW4, SW5, SW6, SW7, SW8, SW9, SW10, SW11, SW12, SW13, SW14, SW15, SW16: TACT; TL1100DF160Q

Connections:
3V3: SW1.1, SW1.3 (1), SW2.1, SW2.3 (1), SW3.1, SW3.3 (1), SW4.1, SW4.3 (1), SW5.1, SW5.3 (1), SW6.1, SW6.3 (1), SW7.1, SW7.3 (1), SW8.1, SW8.3 (1), SW9.1, SW9.3 (1), SW10.1, SW10.3 (1), SW11.1, SW11.3 (1), SW12.1, SW12.3 (1), SW13.1, SW13.3 (1), SW14.1, SW14.3 (1), SW15.1, SW15.3 (1), SW16.1, SW16.3 (1); also elsewhere on the board
BTN_0: C40.2, R16.1; also elsewhere on the board
BTN_1: C31.2, R7.1; also elsewhere on the board
BTN_2: C34.2, R10.1; also elsewhere on the board
BTN_3: C37.2, R13.1; also elsewhere on the board
BTN_4: C30.2, R6.1; also elsewhere on the board
BTN_5: C33.2, R9.1; also elsewhere on the board
BTN_6: C36.2, R12.1; also elsewhere on the board
BTN_7: C29.2, R5.1; also elsewhere on the board
BTN_8: C32.2, R8.1; also elsewhere on the board
BTN_9: C35.2, R11.1; also elsewhere on the board
BTN_AMPS: C41.2, R17.1; also elsewhere on the board
BTN_CANCEL: C38.2, R14.1; also elsewhere on the board
BTN_DP: C39.2, R15.1; also elsewhere on the board
BTN_ON0FF: C27.2, R3.1; also elsewhere on the board
BTN_OUT_CONT: C28.2, R4.1; also elsewhere on the board
BTN_VOLTS: C42.2, R18.1; also elsewhere on the board
GND: C27.1, C28.1, C29.1, C30.1, C31.1, C32.1, C33.1, C34.1, C35.1, C36.1, C37.1, C38.1, C39.1, C40.1, C41.1, C42.1; also elsewhere on the board
unnamed: R3.2, SW1.2, SW1.4 (2)
unnamed: R4.2, SW2.2, SW2.4 (2)
unnamed: R5.2, SW3.2, SW3.4 (2)
unnamed: R6.2, SW4.2, SW4.4 (2)
unnamed: R7.2, SW5.2, SW5.4 (2)
unnamed: R8.2, SW6.2, SW6.4 (2)
unnamed: R9.2, SW7.2, SW7.4 (2)
unnamed: R10.2, SW8.2, SW8.4 (2)
unnamed: R11.2, SW9.2, SW9.4 (2)
unnamed: R12.2, SW10.2, SW10.4 (2)
unnamed: R13.2, SW11.2, SW11.4 (2)
unnamed: R14.2, SW12.2, SW12.4 (2)
unnamed: R15.2, SW13.2, SW13.4 (2)
unnamed: R16.2, SW14.2, SW14.4 (2)
unnamed: R17.2, SW15.2, SW15.4 (2)
unnamed: R18.2, SW16.2, SW16.4 (2)

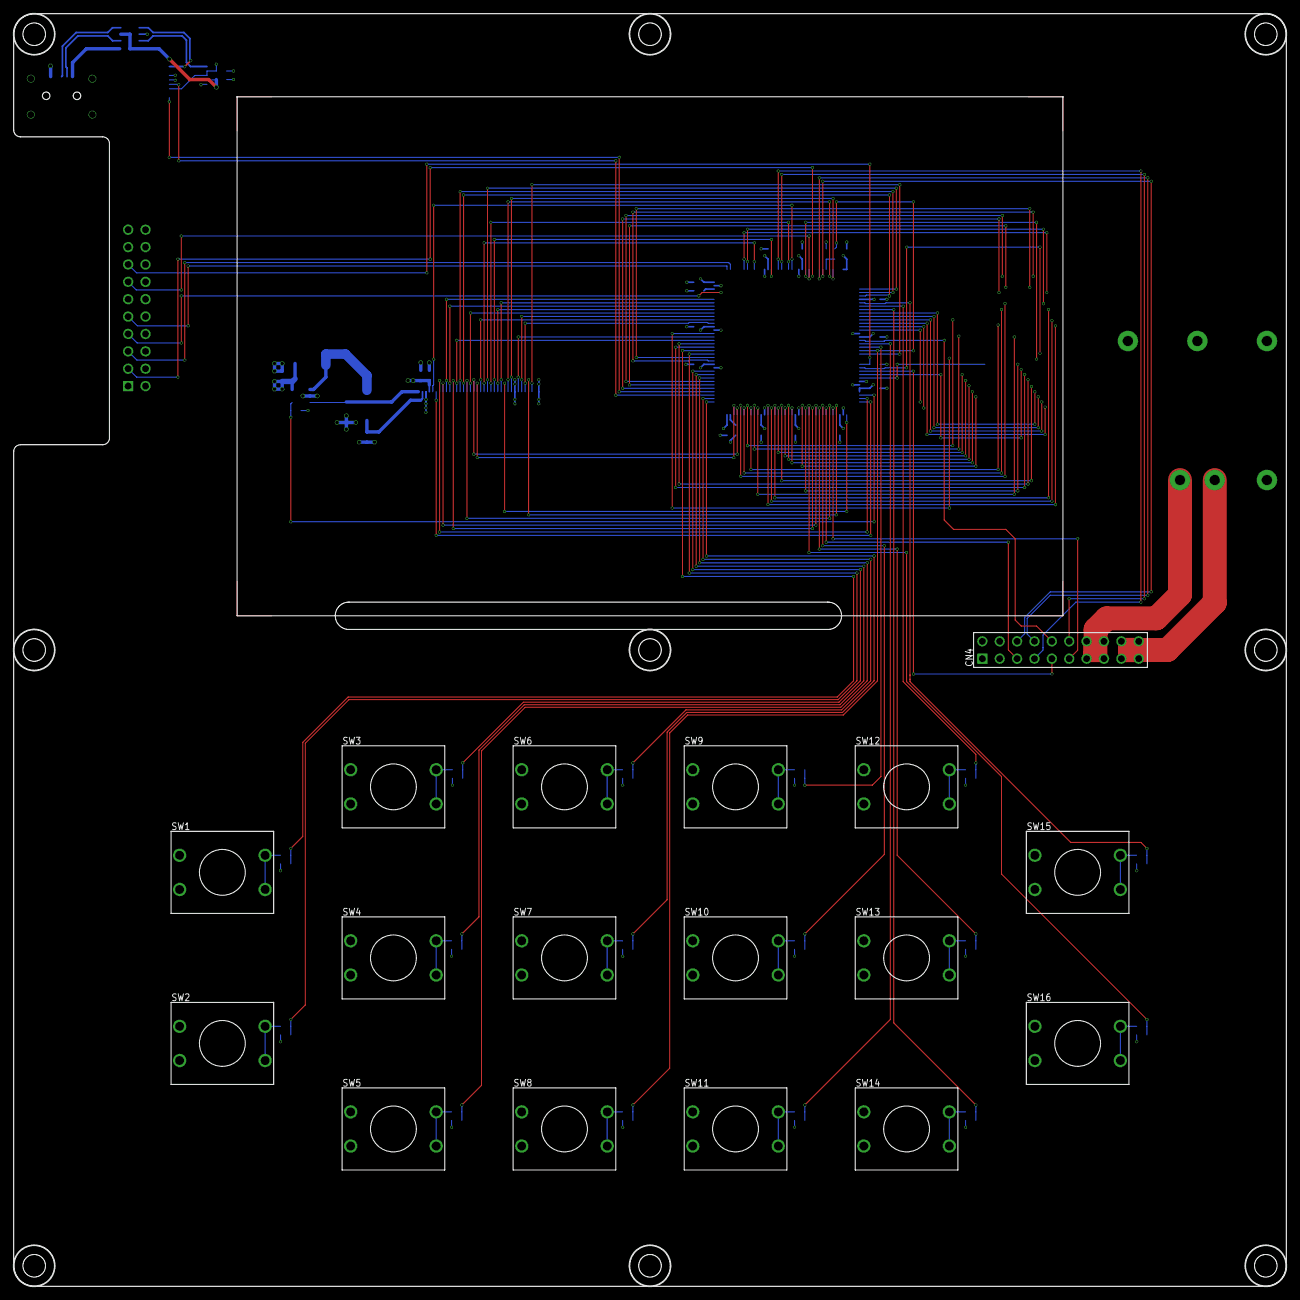
[picture p10: board control.brd from above]

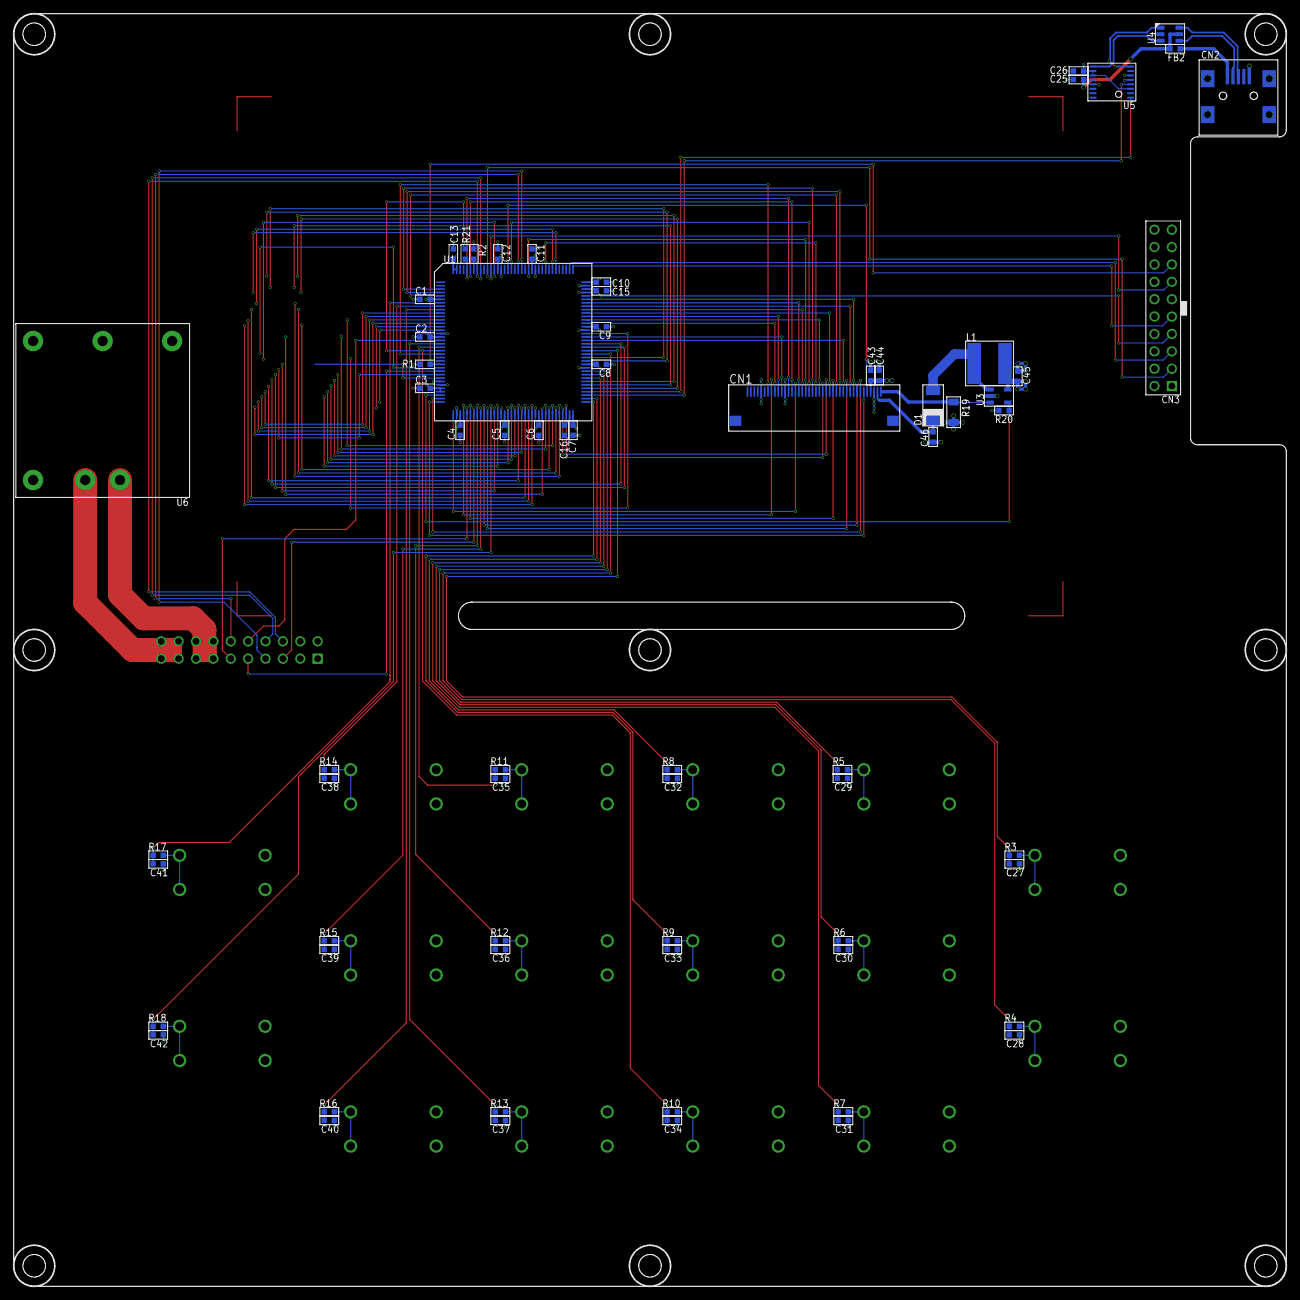
[picture p11: board control.brd from below]

Board: 4 copper layers, 186.0 x 186.0 mm, 95 parts (69 on the bottom side), 95 nets.
