gswdh/PSU-Hardware/(commit log)

2020-09-30 The start
    [PSU Front Panel Design.brd, control.brd, control.sch, power.brd, power.sch]
2020-09-30 Work on the control
    [control.brd, control.sch]
2020-10-03 Progress on PCBs
    [control.brd, control.sch, power.brd, power.sch]
2020-10-08 Control nearly done
    [control.brd, control.sch, power.brd, power.sch]
2020-10-08 Stencil for button added
    [button_screens.brd]
2020-10-08 Female header added to the power PCB
    [power.brd, power.sch]
2020-10-08 DRC passes on both PCBs, pushed to Fusion
    [control.brd, power.brd]
2020-10-08 Bridge connector fixed
    [control.brd]
2020-10-08 Checked against Cube
    [control.brd, control.sch]
2020-10-09 Updated libs with digikey numbers
    [control.brd, control.sch]
2020-10-09 BoM sorted for the power PCB
    [power.brd, power.sch]
2020-10-09 Added control for the output relay
    [PSU Front Panel Design.brd, control.brd, control.sch, power.brd, power.sch]
2020-10-11 Corrected JTAG pinout
    [control.brd, power.brd]
2020-10-11 Button screens screated
    [button_screens_text_only.brd, button_screens_type1.brd, button_screens_type2.brd]
2020-10-11 Latest in Fusion and GERBERs generated
    [control.brd]
2020-10-26 GUI designed in Eagle
    [gui_design.brd, gui_design.dxf]
2020-10-30 Fixes for stability
    [control.brd, control.sch, power.brd, power.sch]
2020-11-01 Removed media objects
    [button_screens_text_only.brd, button_screens_type1.brd, button_screens_type2.brd, gui_design.brd, gui_design.dxf]
